RD9D/IU4NIZ-hf-LDMOS-PA-controller/NIZcontroller images/IMG_20220324_134551.jpg

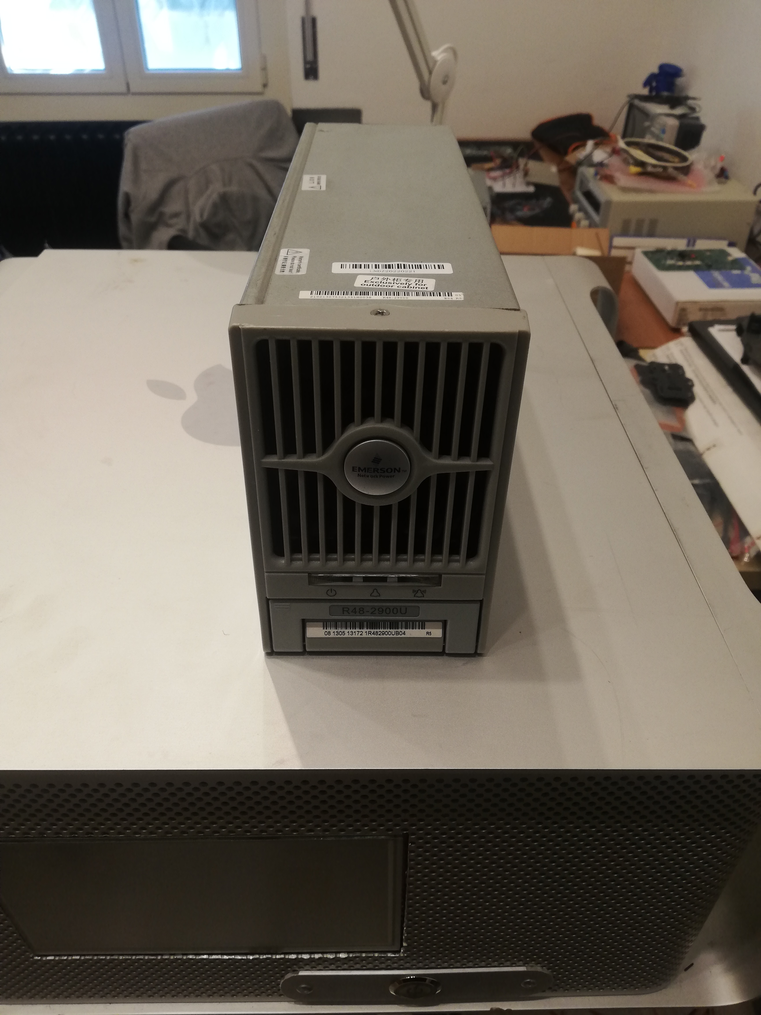
NIZcontroller images/IMG_20220324_134551.jpg
