RD9D/IU4NIZ-hf-LDMOS-PA-controller/Schermata 2023-02-18 alle 13.28.50.png

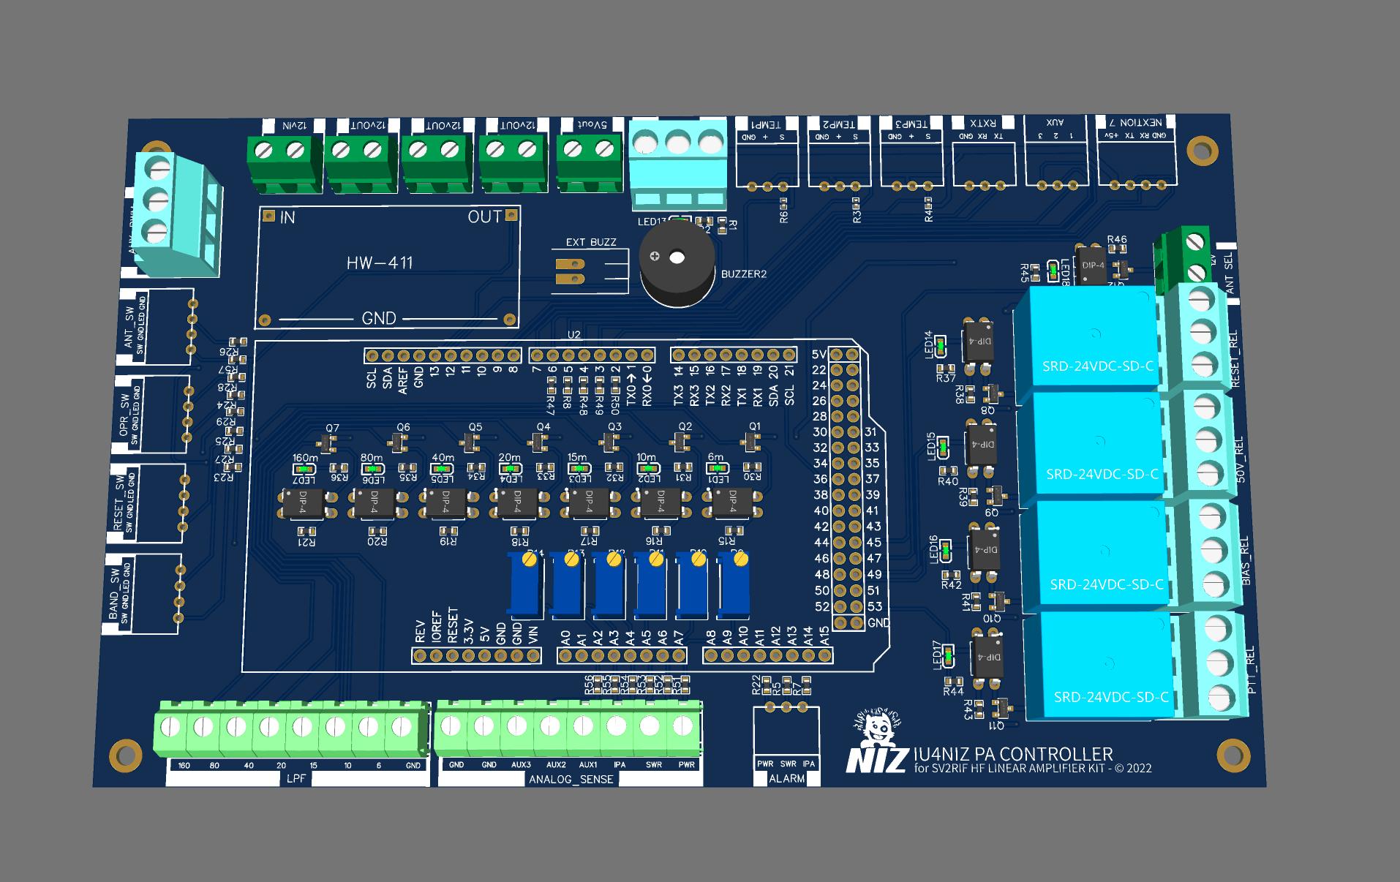
Schermata 2023-02-18 alle 13.28.50.png
