RD9D/IU4NIZ-hf-LDMOS-PA-controller/Schermata 2023-02-18 alle 13.30.02.png

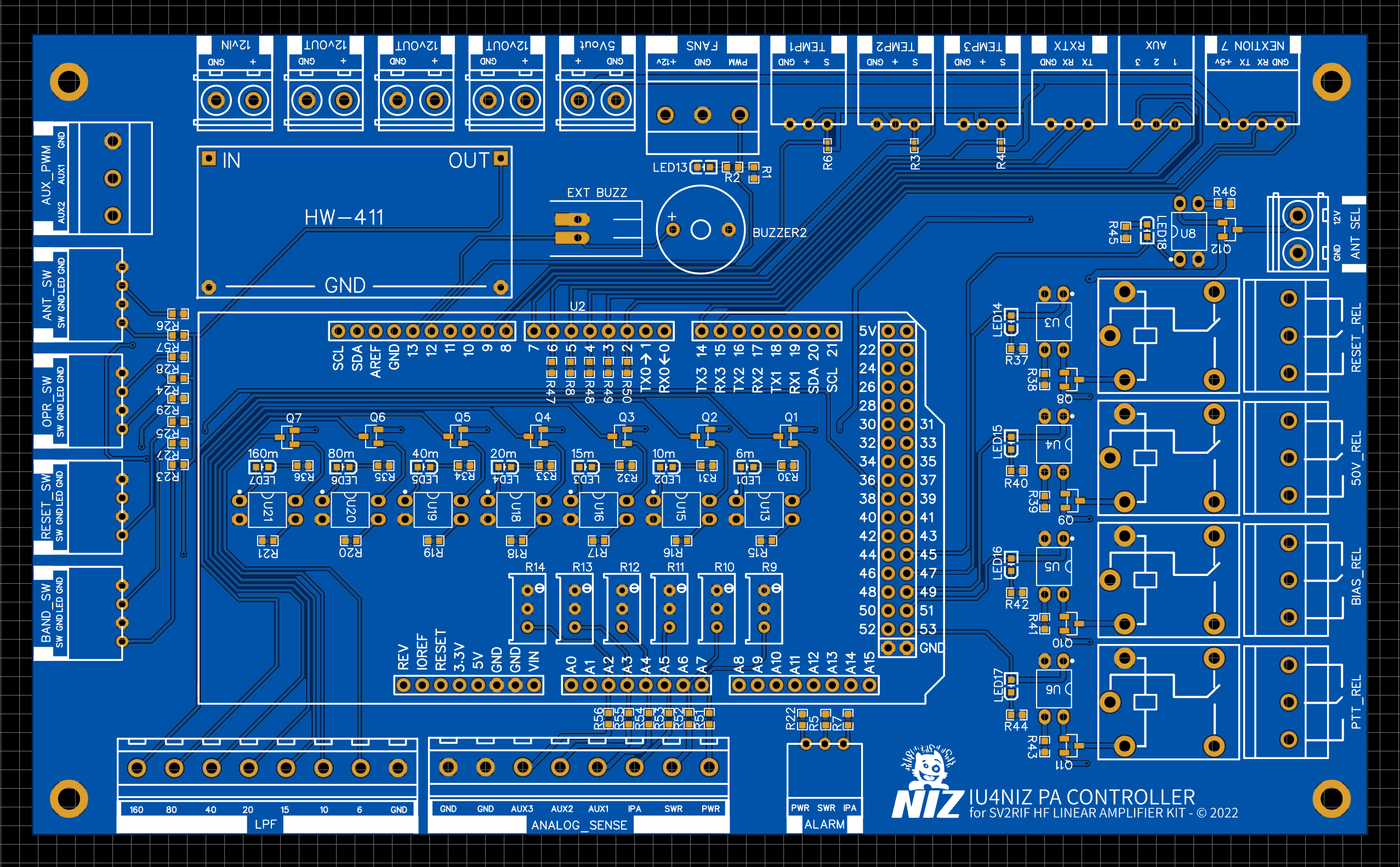
Schermata 2023-02-18 alle 13.30.02.png
