RD9D/IU4NIZ-hf-LDMOS-PA-controller/Schematic_NIZcontroller_V3.pdf

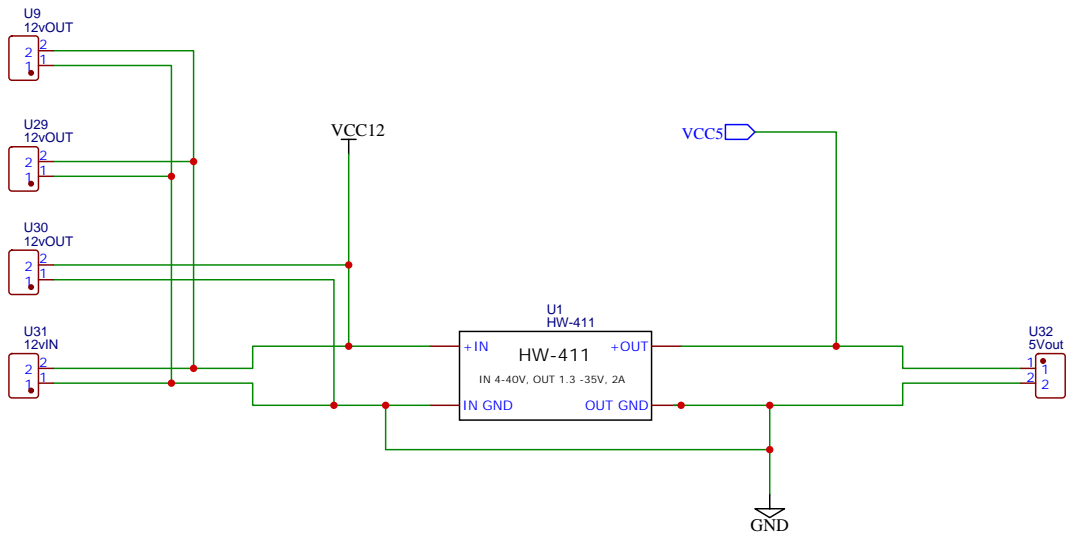
[picture p5: page 1]

Drawn By: Lucio Agnelli

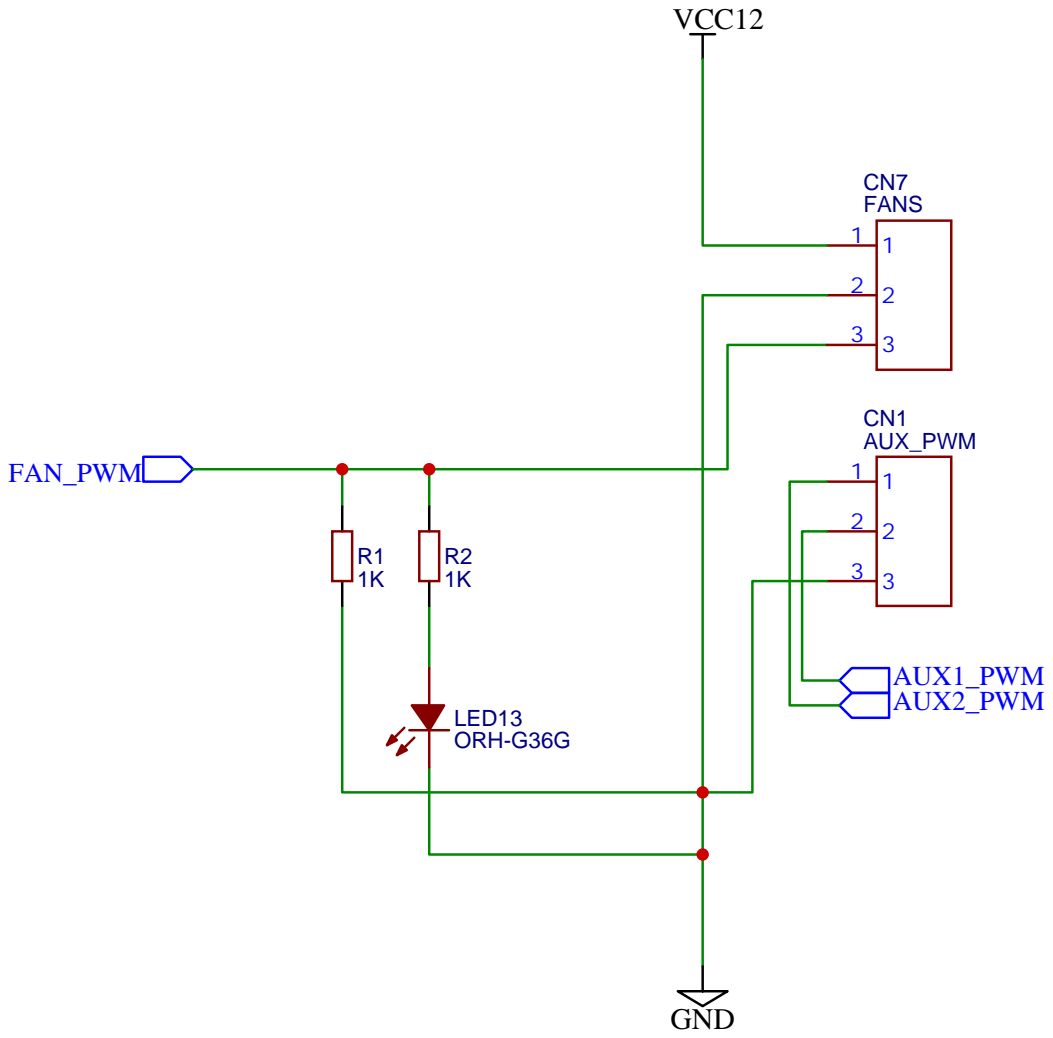
[picture p6: page 2]

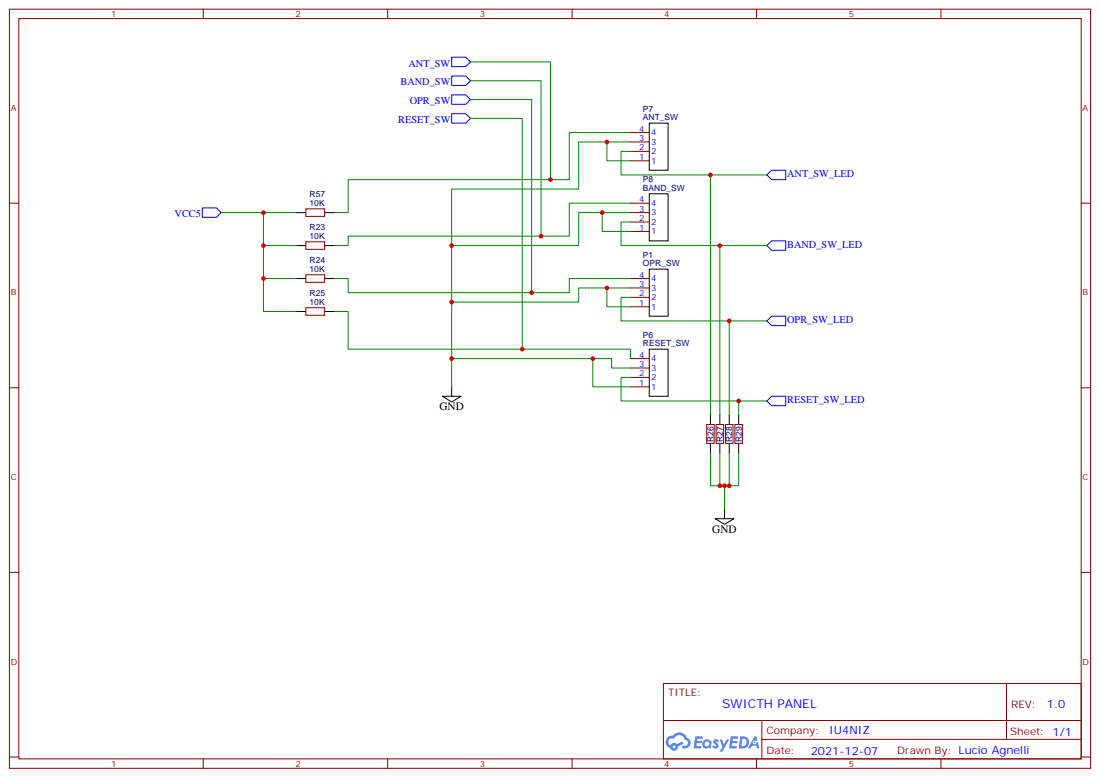
[picture p7: page 3]

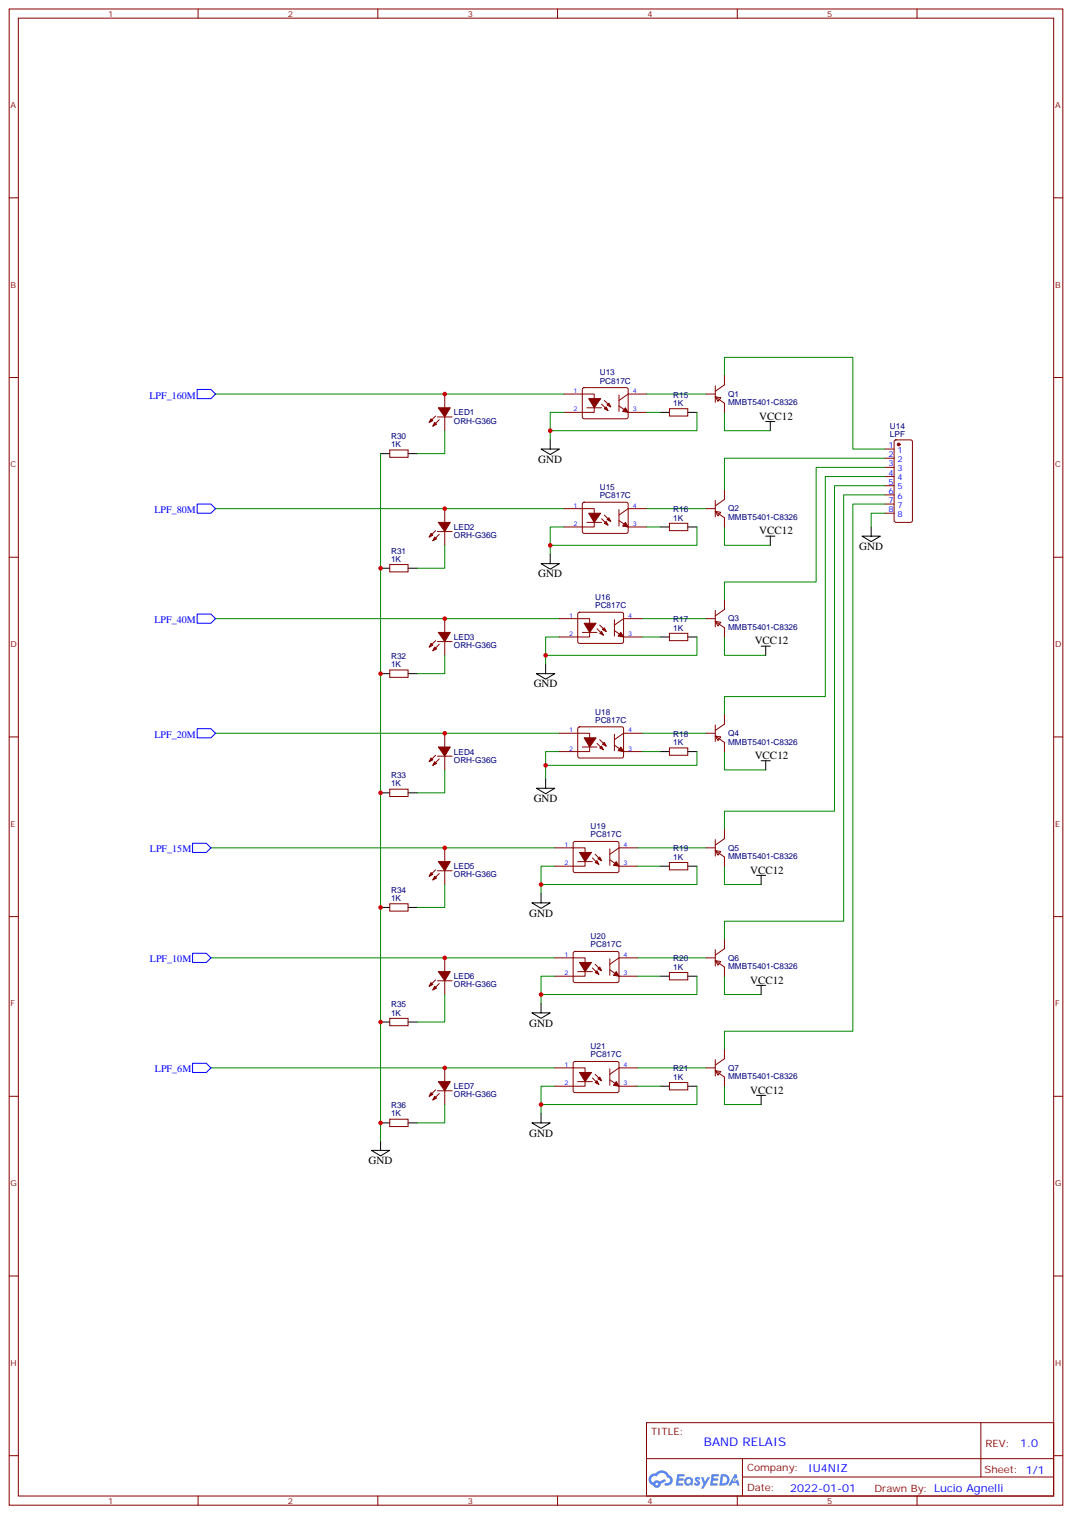
[picture p8: page 4]

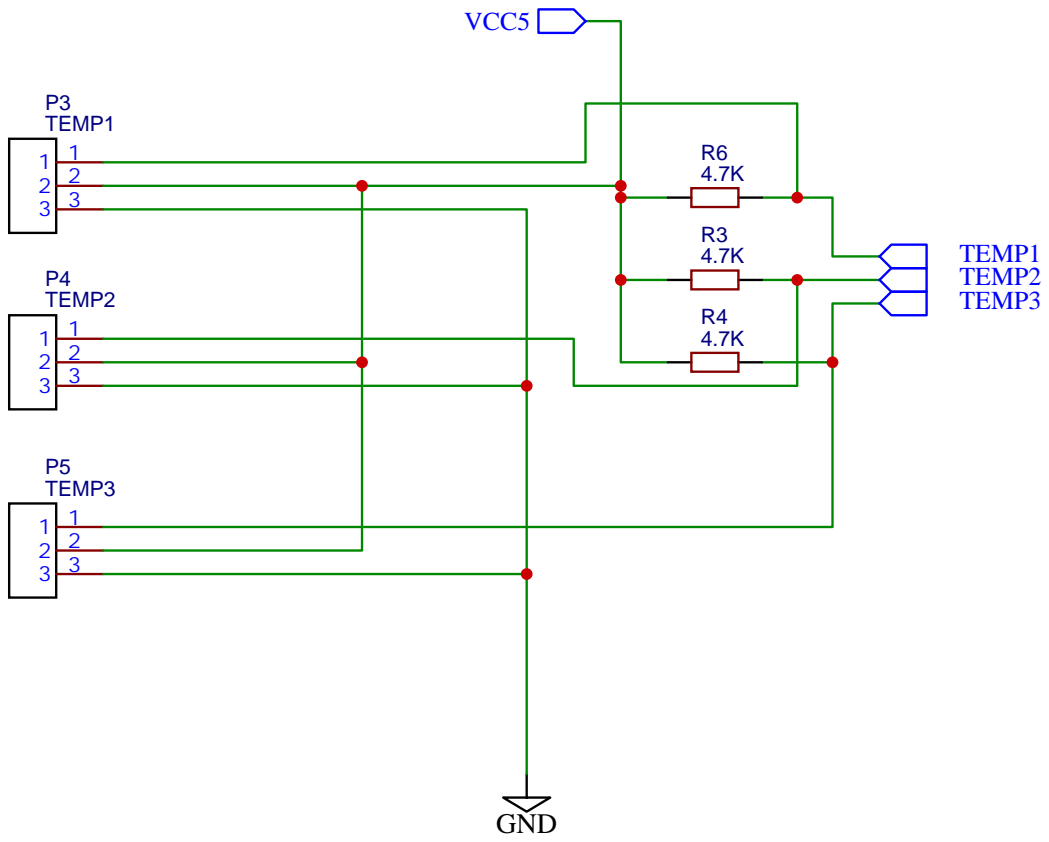
[picture p9: page 5]

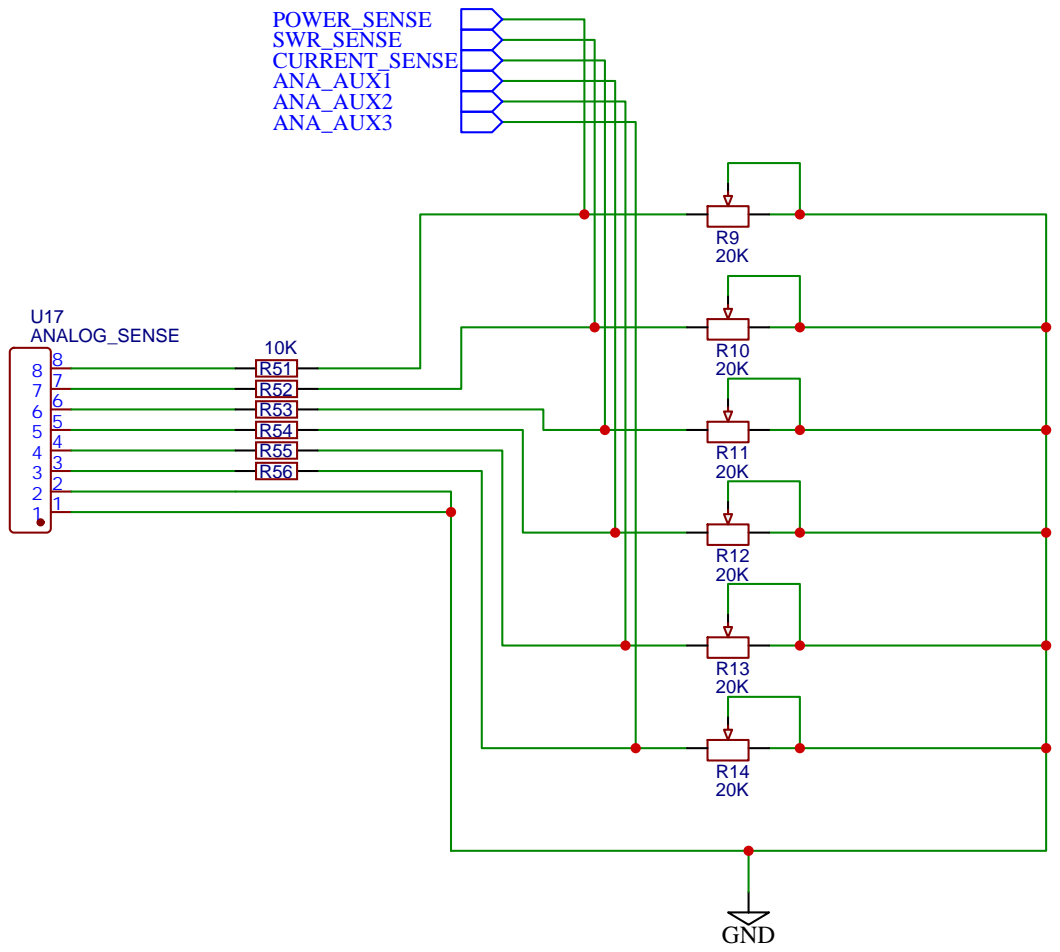
[picture p10: page 6]

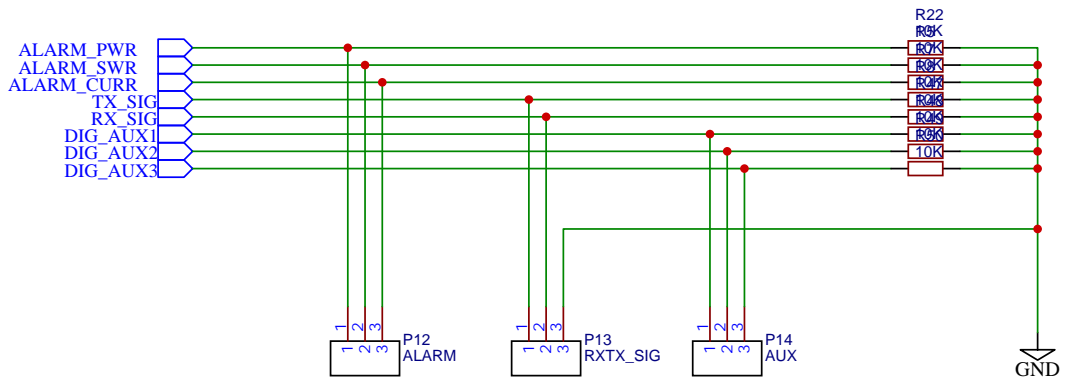
[picture p11: page 7]

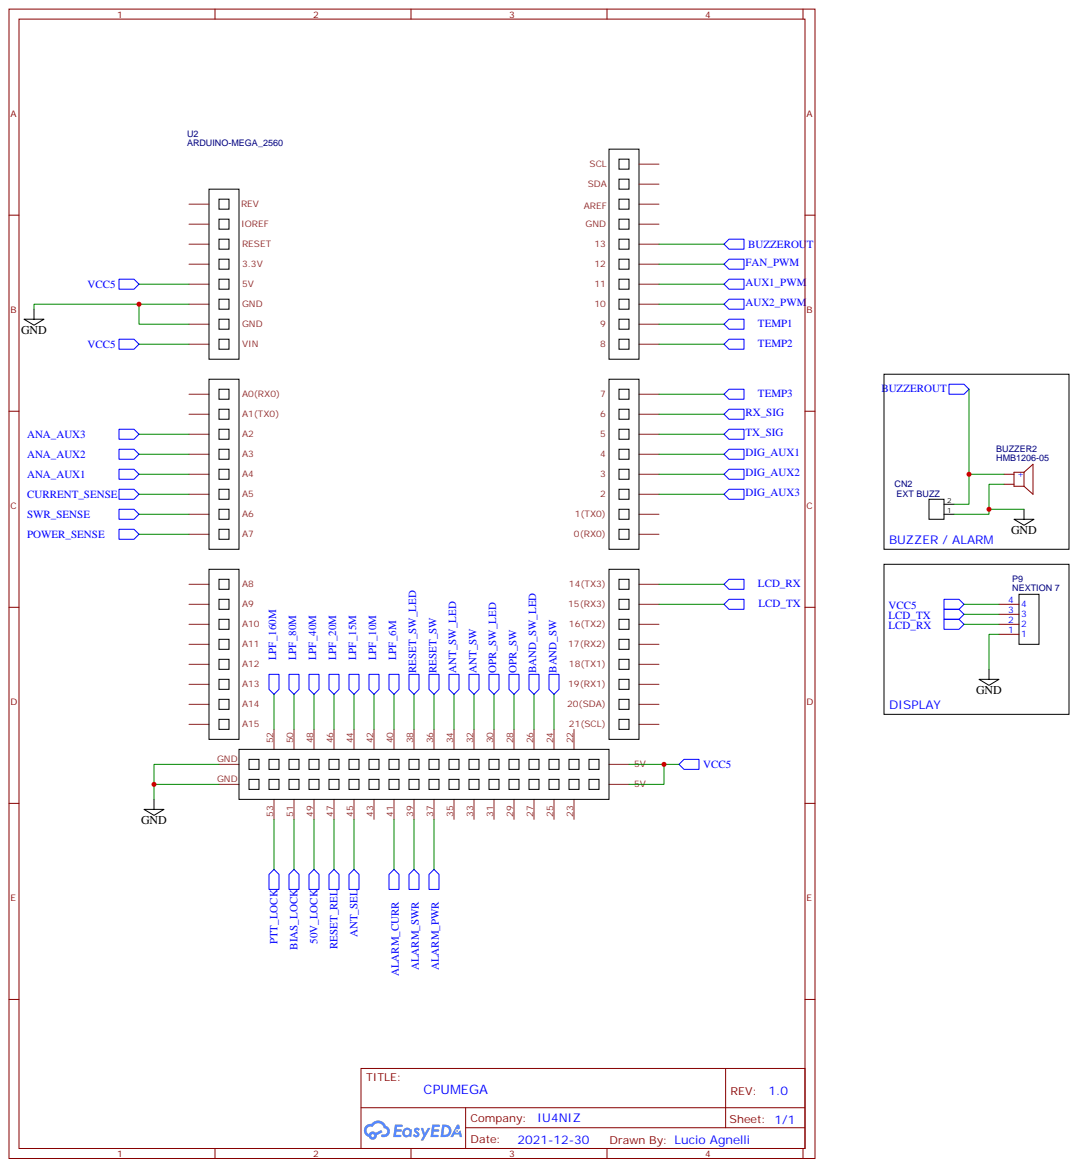
[picture p12: page 8]

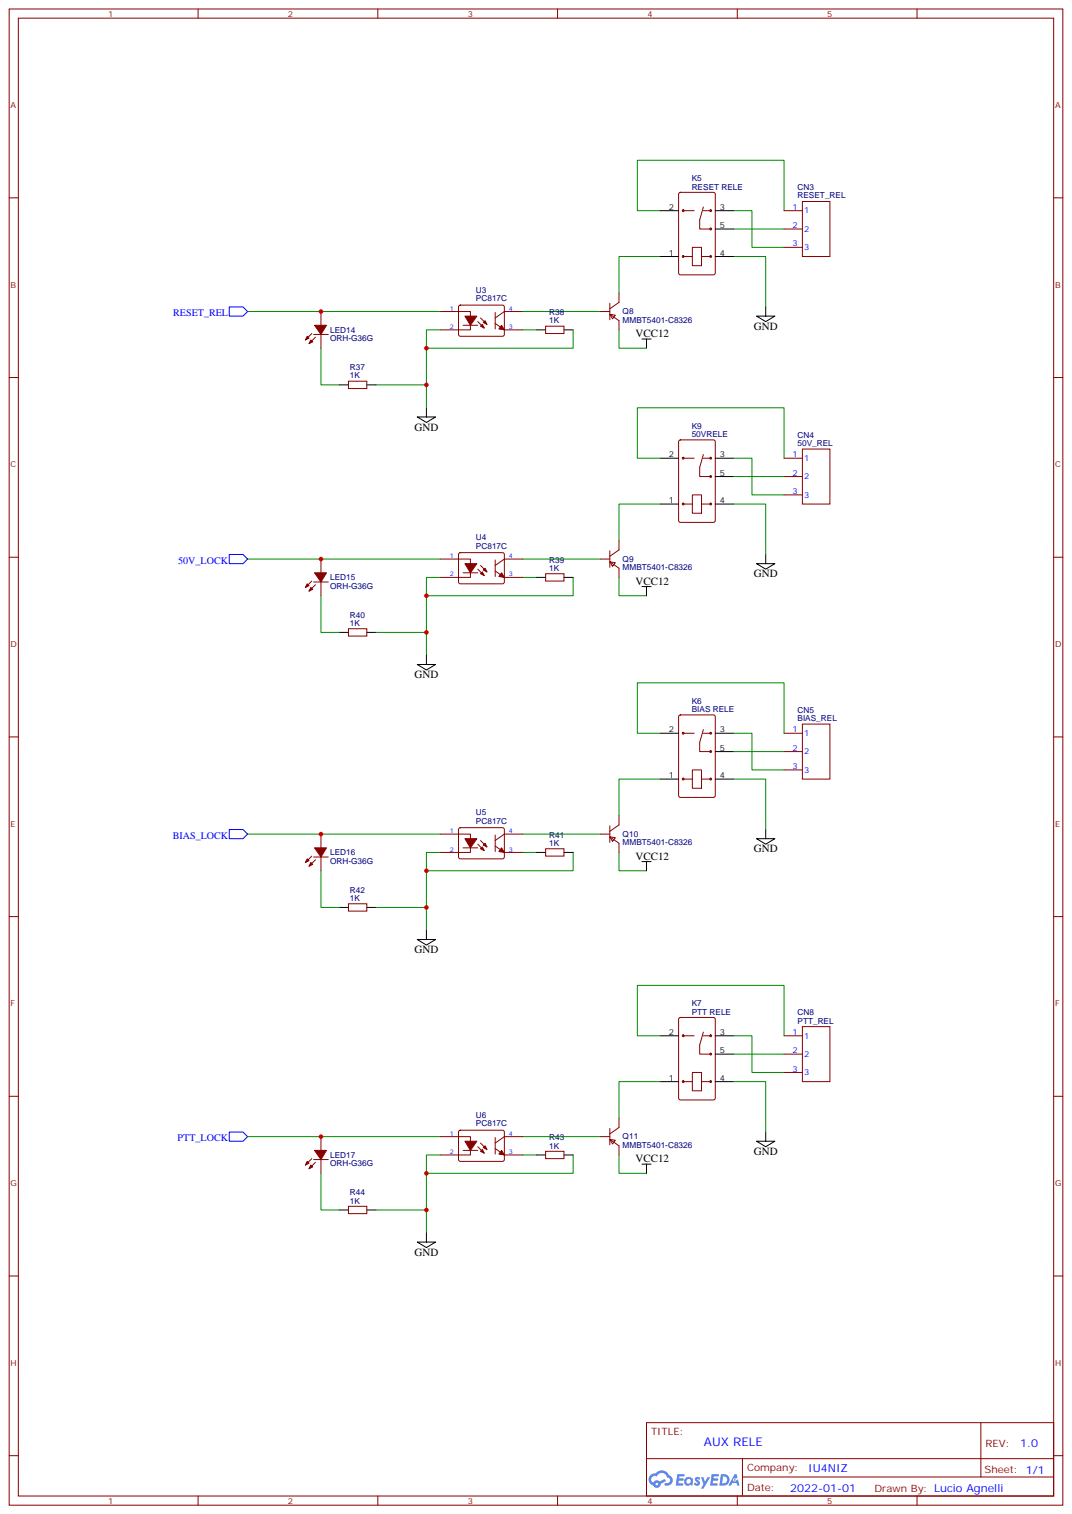
[picture p13: page 9]

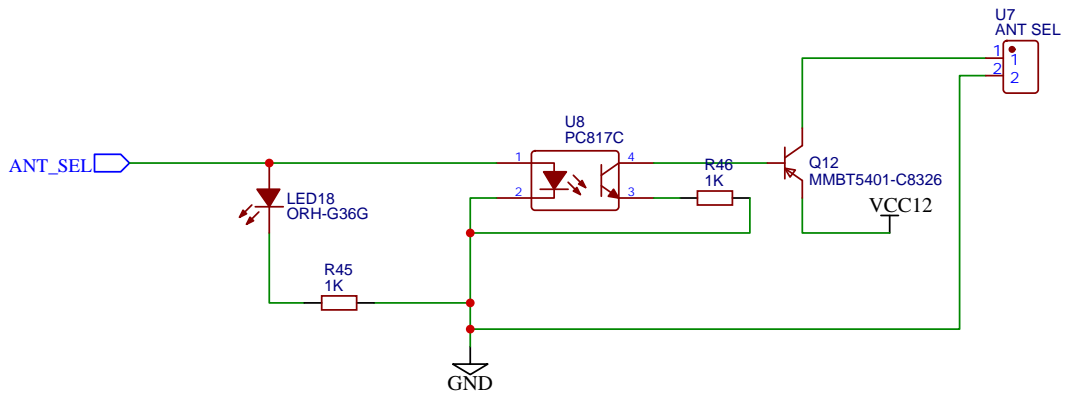
[picture p14: page 10]
