RD9D/IU4NIZ-hf-LDMOS-PA-controller/(commit log)

2022-08-30 Rename BOM_PCB_FURBO CONTROL BOARD Versione 3_4_2022-08-30.csv to BOM_NIZcontroller_V1.csv
    [BOM_NIZcontroller_V1.csv, BOM_PCB_FURBO CONTROL BOARD Versione 3_4_2022-08-30.csv]
2022-08-30 Rename PickAndPlace_PCB_FURBO CONTROL BOARD Versione 3_4_2022-08-30.csv to PickAndPlace_PCB_NIZ_controller_V3.csv
    [PickAndPlace_PCB_FURBO CONTROL BOARD Versione 3_4_2022-08-30.csv, PickAndPlace_PCB_NIZ_controller_V3.csv]
